TU-DO-Makerspace/Ultimaker2Go/Hardware/NTC100KMod/Perfboard.pdf

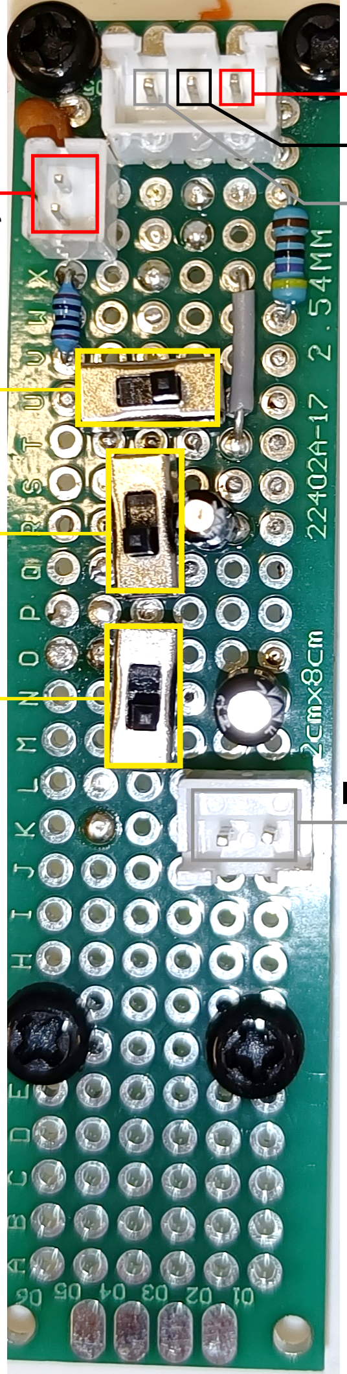
[picture p5: figure]

5V VCC
GND
ADC8

U3_INA826AIDGKR
Vout

i.e. PT100 Output after
dif. amplification

NTC100k

NTC100k
4.7uF Filter Cap

Enabled
Disabled

NTC100k
10uF Filter Cap

Enabled
Disabled

PT100/NTC100k
Toggle

Left:
PT100
Right:
NTC100k
