TU-DO-Makerspace/Ultimaker2Go/Hardware/Ultimainboard/Ultimainboard V2.1.4 Bill of materials.xlsx

Quantity | Comment | Description | Footprint | Mfg | Mfg code | Value | Info | Designator
1 | 1nF | RO C0G 1nF 5% 50V 0603 | C0603 |  |  | 1nF |  | C88
1 | 6,3uH / 3A | RO SPOEL 6,3uH 20% NRS6045T 6R3MMGK TAIYO YUDEN | NRS6045 | TAIYO YUDEN | NRS6045T 6R3MMGK | 6,3uH / 3A |  | L2
1 | 61729-1011BLF | RO CONN PR USB-B HKS 61729-1011BLF FCI | 61729-1011BLF | FCI | 61729-1011BLF | 61729-1011BLF |  | J3
1 | B2B-XH-A (LF)(SN) | CONN PR 2p B2B-XH-A JST | B2B-XH-A (LF)(SN) | JST (JAPAN SOLDERLESS TERMINALS) | B2B-XH-A (LF)(SN) | B2B-XH-A (LF)(SN) |  | J34
1 | Bead | RO FERRIET BLM21PG221SN1D 0805 | L0805 |  |  | Bead |  | L1
1 | Green | RO LED GROEN HSMG-C170 0805 AVAGO | LED0805-GREEN | AVAGO | HSMG-C170 | Green |  | D7
1 | HEADER 3 | HEADER-1x3P-ST-2.54 | HEADER-1x3P-ST-2.54 |  |  | HEADER 3 |  | J26
1 | HEADER 4 | HEADER-1x4P-ST-2.54 | HEADER-1x4P-ST-2.54 |  |  | HEADER 4 |  | J22
1 | HEADER 5 | HEADER-1x5P-ST-2.54 | HEADER-1x5P-ST-2.54 |  |  | HEADER 5 |  | J24
1 | HEADER 8 | HEADER-1x8P-ST-2.54 | HEADER-1x8P-ST-2.54 |  |  | HEADER 8 |  | J25
1 | HEADER-2x2P-ST-2.54 | HDR 2X2P | HEADER-2x2P-ST-2.54 |  |  | HEADER-2x2P-ST-2.54 |  | J4
1 | MC000038 | RO CONN PR 6p MC000038 MULTICOMP | MC000038 | MULTICOMP | MC000038 | MC000038 |  | J21
1 | Relay-SPDT | RO REL 5V HRS4-S DC5V MULTICOMP | HRS4-S | MULTICOMP | HRS4-S DC5V | HRS4-S |  | K1
1 | S3B-XH-A (LF)(SN) | RO CONN PR 3p HKS S3B-XH-A (LF)(SN) JST | S3B-XH-A (LF)(SN) | JST (JAPAN SOLDERLESS TERMINALS) | S3B-XH-A (LF)(SN) | S3B-XH-A (LF)(SN) |  | J9
1 | SOLDER JUMPER | SOLDER JUMPER | JUMPER 2 SOLDER | - | - | SOLDER JUMPER |  | JP2
1 | SW-SPDT | Rocker switch,SPDT,on-none-on,RA,snap-in | RS 734-6918 | RS Components | 4MS1R202BM6NQNS | SPDT |  | SW1
11 | 1uF | RO X5R 1uF 10% 10V 0603 | C0603 |  |  | 1uF |  | C6, C15, C21, C27, C35, C46, C47, C50, C51, C72, C73
2 | 10uF | RO X5R 10UF 10% 35V 1206 | C1206 |  |  | 10uF |  | C38, C39
2 | 1uF | X7R 1uF 10% 50V 1206 GRM31 | C1206 |  |  | 1uF |  | C111, C112
2 | 22nF | RO X7R 22nF 10% 0603 50V CC0603KRX7R9BB223 | C0603 |  |  | 22nF |  | C30, C114
2 | BOXHEADER-10P-R/A-ST-2.54 | RO CONN PR HDR BOX 10p HKS 61201021721 WUERTH | BOXHEADER-10P-R/A-ST-2.54 |  |  | BOXHEADER-10P-R/A-ST-2.54 |  | J32, J33
2 | HEADER 2 | HEADER-1x2P-ST-2.54 | HEADER-1x2P-ST-2.54 |  |  | HEADER 2 |  | J19, JP3
2 | Yellow | RO LED GEEL HSMY-C170 0805 AVAGO | LED0805-YELLOW | AVAGO | HSMY-C170 | Yellow |  | D3, D4
3 | 10uF | 6R3R15X106KV4E - MLCC, 0805, X5R, 6.3V, 10UF | C0805 | JOHANSON DIELECTRICS | 6R3R15X106KV4E | 10uF |  | C86, C87, C115
3 | 22pF | RO C0G 22pF 2% 50V 0603 | C0603 |  |  | 22pF |  | C1, C7, C9
3 | HEADER-2x3P-ST-2.54 | RO CONN PR HDR 2X3P H4B-06DS-0000 INT | HEADER-2x3P-ST-2.54 |  |  | HEADER-2x3P-ST-2.54 |  | J1, J2, J23
3 | Red | RO LED ROOD HSMH-C170 0805 AVAGO | LED0805-RED | AVAGO | HSMH-C170 | Red |  | D10, D11, D12
4 | M3-10ET | MOER-SMD SMTSO-M3-10ET PEM, Spacer SMTSO-M3-10ET, Spacer SMTSO-M3-10ET, Spacer SMTSO-M3-10ET | Spacer M3-10ET | PEM | SMTSO-M3-10ET | - |  | SP1, SP2, SP3, SP4
5 | 220nF | RO X7R 220nF 10% 25V 0603 | C0603 |  |  | 220nF |  | C48, C49, C52, C74, C75
5 | 4,7uF | RO X7R 4,7uF 10% 50V 1206 | C1206 |  |  | 4,7uF |  | C56, C60, C64, C78, C82
5 | S4B-XH-A (LF)(SN) | RO CONN PR 4p HKS S4B-XH-A (LF)(SN) JST | S4B-XH-A (LF)(SN) | JST (JAPAN SOLDERLESS TERMINALS) | S4B-XH-A (LF)(SN) | S4B-XH-A (LF)(SN) |  | J27, J28, J29, J30, J31
57 | 100nF | RO X7R 100nF 10% 50V 0603 | C0603 |  |  | 100nF |  | C2, C3, C4, C5, C8, C10, C11, C12, C13, C14, C17, C18, C19, C20, C22, C24, C25, C26, C29, C31, C32, C40, C41, C42, C43, C44, C45, C57, C58, C59, C61, C62, C63, C65, C66, C67, C68, C69, C70, C71, C79, C80, C81, C83, C84, C85, C91, C92, C100, C101, C102, C103, C104, C105, C110, C113, C116
6 | 10nF | RO X7R 10nF 10% 50V 0603 | C0603 |  |  | 10nF |  | C16, C23, C28, C33, C90, C117
6 | S2B-XH-A (LF)(SN) | RO CONN PR 2p HKS S2B-XH-A (LF)(SN) JST | S2B-XH-A (LF)(SN) | JST (JAPAN SOLDERLESS TERMINALS) | S2B-XH-A (LF)(SN) | S2B-XH-A (LF)(SN) |  | J5, J6, J8, J16, J17, J20
7 | 100uF/35V | RO ELCO 100uF 20% 35V CASE-D EEEFP PAN | ELCO Case D |  |  | 100uF/35V |  | C36, C37, C53, C54, C55, C76, C77
5 | MOLEX-22-05-7028 | RO CONN PR 2p HKS 22-05-7028 MOLEX | MOLEX-22-05-7028 | MOLEX | 22-05-7028 | MOLEX-22-05-7028 | 2.54mm Pitch KK® Wire-to-Board Header, Right Angle, with Friction Lock, 2 Circuits | J7, J11, J13, J14, J15
1 | ATMEGA2560-16AU | RO IC ATMEGA2560-16AU TQFP-100 ATMEL | TSQFP50P1600X1600X120-100N | Atmel | ATMEGA2560-16AU | ATMEGA2560-16AU | 8-bit Atmel Microcontroller with 256KB Flash, 4KB EEPROM, 8KB RAM | U1
1 | ATMEGA16U2-MU | RO IC ATMEGA16U2-MU QFN-32 ATMEL | QFN50P500X500X100-32-EX | Atmel | ATMEGA16U2-MU | ATMEGA16U2-MU | 8-bit Microcontroller with 16K Bytes of ISP Flash and USB Controller | U2
3 | BC817 | RO TRANS BC817-25 SOT-23 | SOT23 |  |  | BC817 | 45 V, 500 mA NPN general-purpose transistors | T1, T2, T100
1 | BC807 | RO TRANS BC807-40 SOT-23 | SOT23 |  |  | BC807 | 45 V, 500 mA PNP general-purpose transistors | T3
1 | LP2985A-33DBVTE4 | RO STABI LP2985A-33DBVTE4 SOT-23-5 TI | SOT95P280X145-5N (SOT23-5L) | Texas Instruments | LP2985A-33DBVTE4 | LP2985A-33DBVTE4 | 150-mA LOW-NOISE LOW-DROPOUT REGULATOR WITH SHUTDOWN | U9
1 | 16Mhz | RO KRIS 16MHz CSTCE16M0V53-R0 SMD MURATA | CSTC | MURATA | CSTCE16M0V53-R0 | 16Mhz | Build in cap | Y1
5 | A4988 | RO IC A4988 QFN-28 ALLEGRO | QFN50P500X500X100-28-EX | Allegro | A4988SETTR-T | A4988 | DMOS Microstepping Driver with Translator and Overcurrent Protection | U8, U10, U11, U12, U13
8 | S1G | RO DIODE S1G DO-214AC | DO214AC (SMA) |  |  | S1G | Fast Rectifiers 1A 400V | D5, D6, D8, D9, D13, D14, D15, D100
20 | 600E @ 100MHz | FERRIET 742792118 1206 Wurth Elektronik | R1206 | Wurth Elektronics | 1800374 | 600E @ 100MHz | Ferriet | L120, L121, L122, L123, L130, L131, L132, L133, L140, L141, L142, L143, L150, L151, L152, L153, L160, L161, L162, L163
3 | IRF8736PBF | IRF8736PBF - MOSFET, N SO-8 | SOIC127P600X175-8N (SO8) | INTERNATIONAL RECTIFIER | IRF8736PBF | IRF8736PBF | HEXFET Power MOSFET | Q1, Q2, Q3
1 | SSB44-E3/52T | RO DIODE SSB44-E3/52T SMB VISHAY | DO214AA (SMB) | VISHAY | SSB44-E3/52T | SSB44-E3/52T | High-Current Density Surface Mount Schottky Rectifier | D16
1 | 16MHz | RO KRISTAL 16.0MHz HC49/4HSMX SMD CMAC | XT49M-2016M | CMAC | XT49M-2016M | 16MHz | Low Profile SMD Type Crystal Units | Y2
1 | Multifuse | RO ZEK MULTI 500MA SMD 1812 MF-MSMF050-2 BOURNS | Multifuse1812 | BOURNS | MF-MSMF050-2 | 0.5A | MULTIFUSE, SMD, 0.5A | F1
1 | NE555D | RO IC NE555D SO-08 TI | SOIC127P600X175-8N (SO8) | Texas Instruments | SE555DRG4 | NE555D | PRECISION TIMER | U7
3 | INA826AIDGKR | RO IC INA826AIDGKR MSOP-8 TI | TSOP65P490X110-8N (MSOP8) | Texas Instruments | INA826AIDGKR | INA826AIDGKR | Precision, 200-µA Supply Current, 2.7-V to 36-V Supply Instrumentation Amplifier with Rail-to-Rail Output | U3, U4, U5
1 | 120E @ 100MHz | FERRIET BLM18PG121SN1D 0603 MURATA | R0603 | Murata | BLM18PG121SN1D | 120E @ 100MHz | Resistor | L100
1 | 3k92 | RO RES 3k92 1% 0.063W 0603 | R0603 |  |  | 3k92 | Resistor | R108
1 | 47E | RO RES 47E 1% 0,063W 0603 | R0603 |  |  | 47E | Resistor | R105
1 | 750E | RO RES 750E 1% 0,063W 0603 | R0603 |  |  | 750E | Resistor | R110
10 | 0.05E | RO RES 0E05 1% 0,125W 0805 | R0805 | BOURNS | CRL0805-FW-R050ELF | 0.05E | Resistor | R74, R75, R76, R77, R79, R80, R96, R97, R98, R99
15 | 100k | RO RES 100k0 1% 0,063W 0603 | R0603 |  |  | 100k | Resistor | R49, R57, R58, R59, R60, R62, R64, R66, R67, R68, R87, R89, R91, R92, R104
16 | 10k | RO RES 10k0 1% 0,063W 0603 | R0603 |  |  | 10k | Resistor | R1, R2, R3, R5, R20, R23, R31, R34, R38, R41, R46, R84, R85, R86, R102, R103
2 | 0.1E | RES 0E10 1% 0,125W 0805 | R0805 | - | - | 0.1E | Resistor | R106, R107
2 | 1M | RO RES 1M0 1% 0,1W 0603 | R0603 |  |  | 1M | Resistor | R4, R10
2 | 22E | RO RES 22E0 1% 0,063W 0603 | R0603 |  |  | 22E | Resistor | R6, R7
25 | 1k | RO RES 1k0 1% 0,1W 0603 | R0603 |  |  | 1k | Resistor | R11, R12, R13, R14, R15, R18, R26, R30, R43, R44, R45, R47, R48, R51, R52, R53, R69, R70, R71, R72, R93, R94, R109, R111, R120
3 | 5k49 | RO RES 5K49 0,1% 0,063W 25ppm 0603 | R0603 | WELWYN | PCF0603R 5K49B.T1 | 5k49 | Resistor | R22, R33, R40
3 | 604E | RO RES 604E 1% 0,063W 0603 | R0603 | VISHAY DRALORIC | CRCW0603604RFKEA | 604E | Resistor | R73, R78, R95
6 | 2k2 | RO RES 2k2 0,1% 0,063W 25ppm 0603 | R0603 | TE CONNECTIVITY / NEOHM | CPF0603B2K2E1 | 2k2 | Resistor | R19, R24, R29, R35, R37, R42
9 | 100E | RO RES 100E 1% 0,063W 0603 | R0603 |  |  | 100E | Resistor | R17, R21, R27, R32, R36, R39, R54, R55, R56
9 | 4k7 | RO RES 4k70 1% 0,063W 0603 | R0603 |  |  | 4k7 | Resistor | R16, R25, R28, R50, R61, R63, R65, R88, R90
1 | KPJX-4S-S | RO CONN PR KPJX-4S-S KYCON | KPJX-4S-S | KYCON | KPJX-4S-S | KPJX-4S-S | Shielded version | J18
2 | 1N4148 | RO DIODE 1N4148WS-V-GS08 SOT-323 VISHAY | SOD323 | VISHAY |  | 1N4148 | Small Signal Fast Switching Diode | D1, D2
62 | Testpoint 1mm | Testpoint 1mm | Testpoint 1mm | - | - | Testpoint 1mm | Testpoint 1mm | TP400, TP401, TP402, TP403, TP404, TP405, TP406, TP407, TP408, TP409, TP410, TP411, TP414, TP415, TP416, TP417, TP418, TP419, TP420, TP421, TP422, TP425, TP426, TP427, TP428, TP429, TP430, TP431, TP432, TP433, TP434, TP435, TP438, TP439, TP440, TP441, TP442, TP443, TP500, TP501, TP502, TP503, TP504, TP505, TP506, TP507, TP508, TP509, TP510, TP511, TP514, TP515, TP516, TP517, TP518, TP519, TP520, TP521, TP524, TP525, TP526, TP527
108 | Testpoint 1.6mm | Testpoint 1.6mm | Testpoint 1.6mm | - | - | Testpoint 1.6mm | Testpoint 1.6mm | TP105, TP106, TP107, TP108, TP110, TP111, TP113, TP114, TP115, TP116, TP117, TP118, TP119, TP120, TP125, TP126, TP130, TP131, TP132, TP133, TP134, TP135, TP136, TP137, TP138, TP139, TP140, TP141, TP142, TP143, TP144, TP145, TP146, TP147, TP148, TP149, TP151, TP152, TP153, TP154, TP155, TP156, TP159, TP160, TP161, TP162, TP163, TP164, TP165, TP166, TP167, TP168, TP169, TP170, TP171, TP172, TP173, TP174, TP175, TP176, TP177, TP178, TP179, TP180, TP189, TP190, TP191, TP200, TP201, TP202, TP203, TP204, TP205, TP206, TP207, TP208, TP209, TP210, TP211, TP212, TP213, TP214, TP215, TP216, TP217, TP218, TP219, TP300, TP301, TP302, TP303, TP304, TP305, TP307, TP308, TP309, TP310, TP311, TP312, TP313, TP314, TP315, TP316, TP317, TP318, TP319, TP320, TP321
82 | Testpoint | Testpoint | Testpoint | - | - | Testpoint | Testpoint, 2mm, round | TP1, TP2, TP3, TP4, TP5, TP6, TP7, TP8, TP9, TP10, TP11, TP12, TP13, TP14, TP15, TP16, TP17, TP18, TP19, TP20, TP21, TP22, TP23, TP24, TP25, TP26, TP27, TP28, TP29, TP30, TP31, TP32, TP33, TP34, TP35, TP36, TP37, TP38, TP39, TP40, TP41, TP42, TP43, TP44, TP45, TP46, TP47, TP48, TP49, TP50, TP51, TP52, TP53, TP54, TP55, TP56, TP57, TP58, TP59, TP60, TP61, TP62, TP63, TP64, TP65, TP66, TP67, TP68, TP69, TP70, TP71, TP72, TP73, TP74, TP75, TP76, TP77, TP78, TP79, TP80, TP100, TP101
1 | A4403GEUTR-T | RO IC A4403GEUTR-T QFN-16 ALLEGRO | QFN65P400X400X80-16N-EX | Allegro | A4403GEUTR-T | A4403GEUTR-T | Valley Current Mode Control Buck Converter | U6
2 | 20V | RO VDR 0603 CG0603MLC-05E | R0603 | BOURNS | CG0603MLC-05E | 20V | Varistor | R8, R9
