TU-DO-Makerspace/Ultimaker2Go/Hardware/NTC100KMod/Changes.PDF

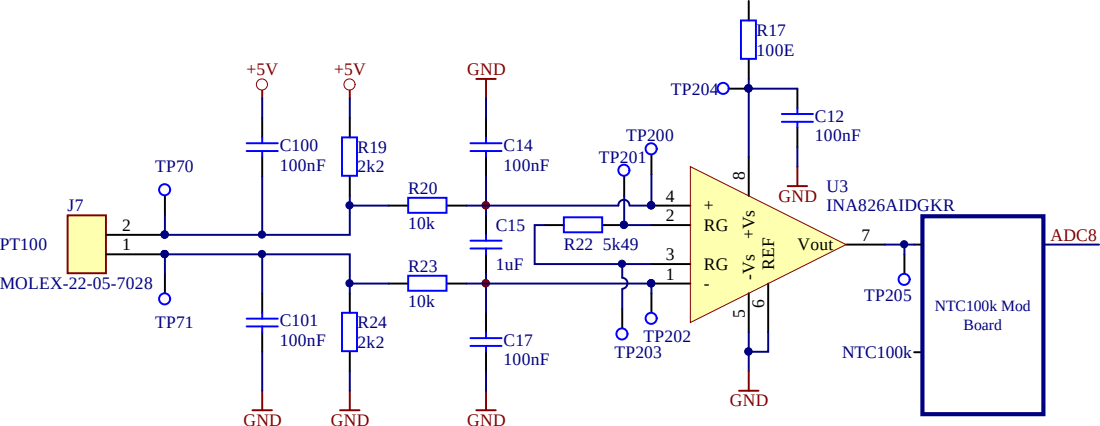
[picture p12: page 1]
