TU-DO-Makerspace/Ultimaker2Go/Hardware/NTC100KMod/NTC100KMod.kicad_pcb

## KiCad design Akashi-17.kicad_sch

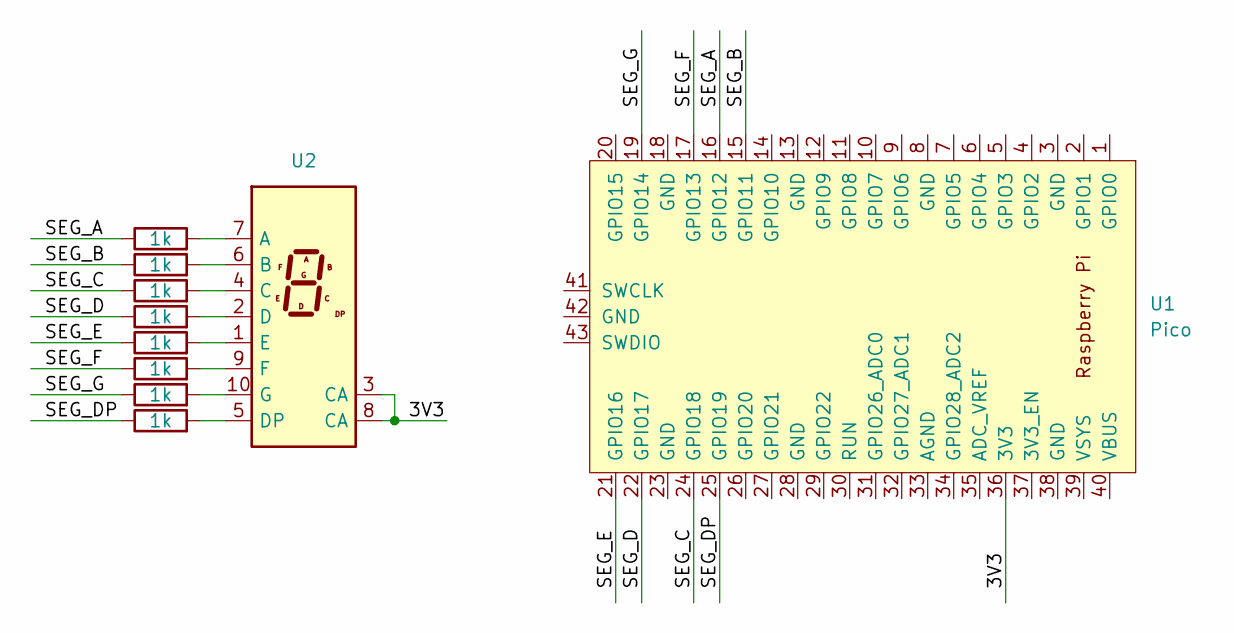
[picture p13: schematic Akashi-17.kicad_sch]

Parts:
R1, R2, R3, R4, R5, R6, R7, R8: 1k
U1: Pico; RPi_Pico_SMD_TH
U2: KCSA02-136; KCSC02-136

Connections:
3V3: U1.36 (3V3), U2.3 (CA), U2.8 (CA)
unnamed: R1.2, U2.7 (A)
unnamed: R2.2, U2.6 (B)
unnamed: R3.2, U2.4 (C)
unnamed: R4.2, U2.2 (D)
unnamed: R5.2, U2.1 (E)
unnamed: R6.2, U2.9 (F)
unnamed: R7.2, U2.10 (G)
unnamed: R8.2, U2.5 (DP)
SEG_A: R1.1, U1.16 (GPIO12)
SEG_B: R2.1, U1.15 (GPIO11)
SEG_C: R3.1, U1.24 (GPIO18)
SEG_D: R4.1, U1.22 (GPIO17)
SEG_DP: R8.1, U1.25 (GPIO19)
SEG_E: R5.1, U1.21 (GPIO16)
SEG_F: R6.1, U1.17 (GPIO13)
SEG_G: R7.1, U1.19 (GPIO14)
