TU-DO-Makerspace/Ultimaker2Go/Marlin/Configuration.h

#define CONFIGURATION_H
#define STRING_VERSION_CONFIG_H __DATE__ " " __TIME__ // build date and time
#define STRING_CONFIG_H_AUTHOR "Version DEV" // Who made the changes.
#define SERIAL_PORT 0
#define BAUDRATE 250000
#define MOTHERBOARD 72
#define EXTRUDERS 1
#define POWER_SUPPLY 2
#define DELTA_SEGMENTS_PER_SECOND 200
#define DELTA_DIAGONAL_ROD 250.0 // mm
#define DELTA_SMOOTH_ROD_OFFSET 175.0 // mm
#define DELTA_EFFECTOR_OFFSET 33.0 // mm
#define DELTA_CARRIAGE_OFFSET 18.0 // mm
#define DELTA_RADIUS (DELTA_SMOOTH_ROD_OFFSET-DELTA_EFFECTOR_OFFSET-DELTA_CARRIAGE_OFFSET)
#define SIN_60 0.8660254037844386
#define COS_60 0.5
#define DELTA_TOWER1_X -SIN_60*DELTA_RADIUS // front left tower
#define DELTA_TOWER1_Y -COS_60*DELTA_RADIUS
#define DELTA_TOWER2_X SIN_60*DELTA_RADIUS // front right tower
#define DELTA_TOWER2_Y -COS_60*DELTA_RADIUS
#define DELTA_TOWER3_X 0.0 // back middle tower
#define DELTA_TOWER3_Y DELTA_RADIUS
#define TEMP_SENSOR_0 5
#define TEMP_SENSOR_1 0
#define TEMP_SENSOR_2 0
#define TEMP_SENSOR_BED 0
#define MAX_REDUNDANT_TEMP_SENSOR_DIFF 10
#define TEMP_RESIDENCY_TIME 3   // (seconds)
#define TEMP_HYSTERESIS 3       // (degC) range of +/- temperatures considered "close" to the target one
#define TEMP_WINDOW     2       // (degC) Window around target to start the residency timer x degC early.
#define HEATER_0_MINTEMP 5
#define HEATER_1_MINTEMP 5
#define HEATER_2_MINTEMP 5
#define BED_MINTEMP 5
#define HEATER_0_MAXTEMP 275    // 275 C limit in Ultimaker 2 since the PTFE coupler degrades rapidly at higher temperatures.
#define HEATER_1_MAXTEMP 275
#define HEATER_2_MAXTEMP 275
#define BED_MAXTEMP 130
#define MAX_HEATING_TEMPERATURE_INCREASE 10
#define MAX_HEATING_CHECK_MILLIS (30 * 1000)
#define PIDTEMP
#define BANG_MAX 255 // limits current to nozzle while in bang-bang mode; 255=full current
#define PID_MAX 255 // limits current to nozzle while PID is active (see PID_FUNCTIONAL_RANGE below); 255=full current
  #define PID_FUNCTIONAL_RANGE 1000 // If the temperature difference between the target temperature and the actual temperature
  #define PID_INTEGRAL_DRIVE_MAX 255  //limit for the integral term
  #define K1 0.99 //smoothing factor within the PID
  #define PID_dT ((OVERSAMPLENR * 4.0)/(F_CPU / 64.0 / 256.0)) //sampling period of the temperature routine
    #define  DEFAULT_Kp 10.0
    #define  DEFAULT_Ki 2.5
    #define  DEFAULT_Kd 100.0
#define MAX_BED_POWER 255 // limits duty cycle to bed; 255=full current
#define PREVENT_DANGEROUS_EXTRUDE
#define PREVENT_LENGTHY_EXTRUDE
#define EXTRUDE_MINTEMP 170
#define EXTRUDE_MAXLENGTH 1000.0 //prevent extrusion of very large distances.
#define ENDSTOPPULLUPS // Comment this out (using // at the start of the line) to disable the endstop pullup resistors
  #define ENDSTOPPULLUP_XMAX
  #define ENDSTOPPULLUP_YMAX
  #define ENDSTOPPULLUP_ZMAX
  #define ENDSTOPPULLUP_XMIN
  #define ENDSTOPPULLUP_YMIN
  #define ENDSTOPPULLUP_ZMIN
const bool X_ENDSTOPS_INVERTING = true; // set to true to invert the logic of the endstops.
const bool Y_ENDSTOPS_INVERTING = true; // set to true to invert the logic of the endstops.
const bool Z_ENDSTOPS_INVERTING = true; // set to true to invert the logic of the endstops.
#if defined(COREXY) && !defined(DISABLE_MAX_ENDSTOPS)
  #define DISABLE_MAX_ENDSTOPS
#endif
#define X_ENABLE_ON 0
#define Y_ENABLE_ON 0
#define Z_ENABLE_ON 0
#define E_ENABLE_ON 0 // For all extruders
#define DISABLE_X false
#define DISABLE_Y false
#define DISABLE_Z false
#define DISABLE_E false // For all extruders
#define INVERT_X_DIR true     // for Mendel set to false, for Orca set to true
#define INVERT_Y_DIR false    // for Mendel set to true, for Orca set to false
#define INVERT_Z_DIR true     // for Mendel set to false, for Orca set to true
#define INVERT_E0_DIR true    // for direct drive extruder v9 set to true, for geared extruder set to false
#define INVERT_E1_DIR true    // for direct drive extruder v9 set to true, for geared extruder set to false
#define INVERT_E2_DIR false   // for direct drive extruder v9 set to true, for geared extruder set to false
#define X_HOME_DIR -1
#define Y_HOME_DIR 1
#define Z_HOME_DIR 1
#define min_software_endstops true // If true, axis won't move to coordinates less than HOME_POS.
#define max_software_endstops true  // If true, axis won't move to coordinates greater than the defined lengths below.
#define X_MAX_POS 122
#define X_MIN_POS -14
#define Y_MAX_POS 124
#define Y_MIN_POS 0
#define Z_MAX_POS 130
#define Z_MIN_POS 0
#define X_MAX_LENGTH (X_MAX_POS - X_MIN_POS)
#define Y_MAX_LENGTH (Y_MAX_POS - Y_MIN_POS)
#define Z_MAX_LENGTH (Z_MAX_POS - Z_MIN_POS)
#define MANUAL_X_HOME_POS 0
#define MANUAL_Y_HOME_POS 0
#define MANUAL_Z_HOME_POS 0
#define NUM_AXIS 4 // The axis order in all axis related arrays is X, Y, Z, E
#define HOMING_FEEDRATE {100*60, 100*60, 40*60, 0}  // set the homing speeds (mm/min)
#define DEFAULT_AXIS_STEPS_PER_UNIT   {80.0,80.0,200,282}  // default steps per unit for Ultimaker2
#define DEFAULT_MAX_FEEDRATE          {300, 300, 40, 45}    // (mm/sec)
#define DEFAULT_MAX_ACCELERATION      {9000,9000,100,10000} // X, Y, Z, E maximum start speed for accelerated moves. E default values are good for skeinforge 40+, for older versions raise them a lot.
#define DEFAULT_ACCELERATION          3000      // X, Y, Z and E max acceleration in mm/s^2 for printing moves
#define DEFAULT_RETRACT_ACCELERATION  3000      // X, Y, Z and E max acceleration in mm/s^2 for retracts
#define DEFAULT_XYJERK                20.0      // (mm/sec)
#define DEFAULT_ZJERK                 0.4       // (mm/sec)
#define DEFAULT_EJERK                 5.0       // (mm/sec)
#define FILAMENT_BOWDEN_LENGTH        550
#define EEPROM_SETTINGS
#define EEPROM_CHITCHAT
#define PLA_PREHEAT_HOTEND_TEMP 180
#define PLA_PREHEAT_HPB_TEMP 70
#define PLA_PREHEAT_FAN_SPEED 0     // Insert Value between 0 and 255
#define ABS_PREHEAT_HOTEND_TEMP 240
#define ABS_PREHEAT_HPB_TEMP 100
#define ABS_PREHEAT_FAN_SPEED 0     // Insert Value between 0 and 255
#define SDSUPPORT // Enable SD Card Support in Hardware Console
#define ENABLE_ULTILCD2 //128x64 pixel display in the Ultimaker 2, with new menus. Note: For compiling with Arduino you need to remove the "SIGNAL(TWI_vect)" function from "libraries/Wire/utility/twi.c"
#define SOFT_PWM_SCALE 0
#define END_OF_PRINT_RETRACTION 20		// number of mm to retract when printer goes idle
#define END_OF_PRINT_RECOVERY_SPEED 5 	// speed to recover that assumed retraction at (mm/s)
#define PRIMING_MM3	50					// number of mm^3 of plastic to extrude when priming
#define PRIMING_MM3_PER_SEC 5			// Rate at which to prime head (in mm^3/s)
#define PRIMING_HEIGHT 20				// Height at which to perform the priming extrusions
#define LEVELING_OFFSET 0.1				// Assumed thickness of feeler gauge/paper used in leveling (mm)
#include "Configuration_adv.h"
#include "thermistortables.h"
