TU-DO-Makerspace/Ultimaker2Go/(commit log)

2023-07-06 Temp Sensors: 2 Go doesn't have a heatbed
    [Configuration.h]
2023-07-06 Temp Sensor: Use correct driver for our NTC100K end temp sensor mod
    [Configuration.h]
2023-07-06 Added schematics, BOM, and PCB overview
    Credits: http://3dprintingforum.us/viewtopic.php?p=11752#p11757
    [Ultimainboard V2.1.4 Bill of materials.xlsx]
2023-07-07 Added NTC100k mod docs
    [NTC100KMod.kicad_pcb, NTC100KMod.kicad_sch, Ultimainboard V2.1.4 Bill of materials.xlsx]
